inggunny/Laboratorio_de_robotica_movil_en_Cloud/piezas 3d/soporte motor individual.stl

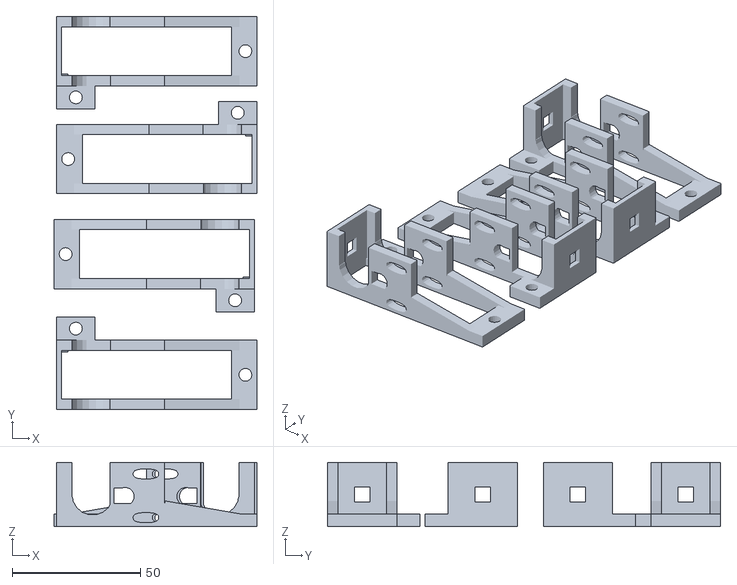
[picture p37: CAD file, 2019-08-13]
piezas 3d/soporte motor individual.stl
79.0 x 153.0 x 25.0
