inggunny/Laboratorio_de_robotica_movil_en_Cloud/piezas 3d/antena.stl

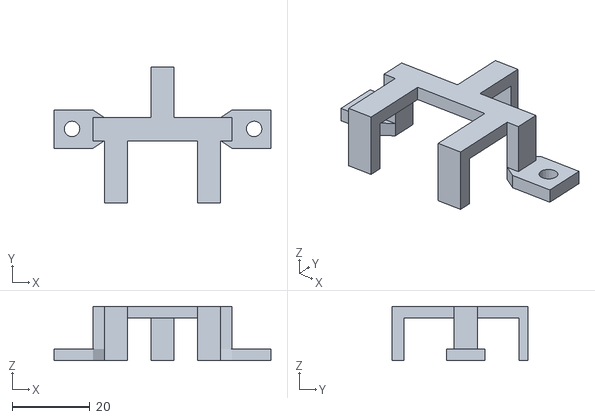
[picture p38: CAD file, 2019-08-13]
piezas 3d/antena.stl
56.0 x 35.0 x 14.0
