inggunny/Laboratorio_de_robotica_movil_en_Cloud/piezas 3d/ultrasonico.stl

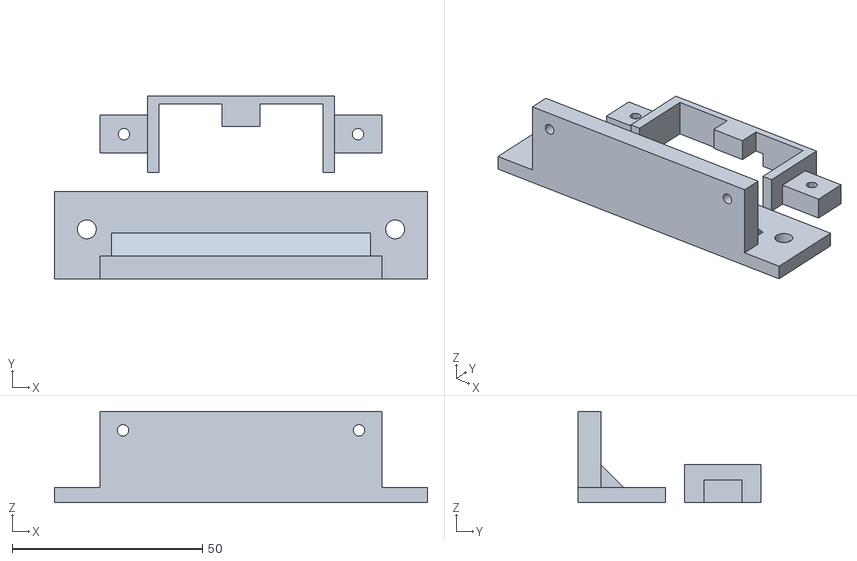
[picture p39: CAD file, 2019-08-13]
piezas 3d/ultrasonico.stl
98.0 x 48.0 x 24.0
