inggunny/Laboratorio_de_robotica_movil_en_Cloud/chasis acrilico.pdf

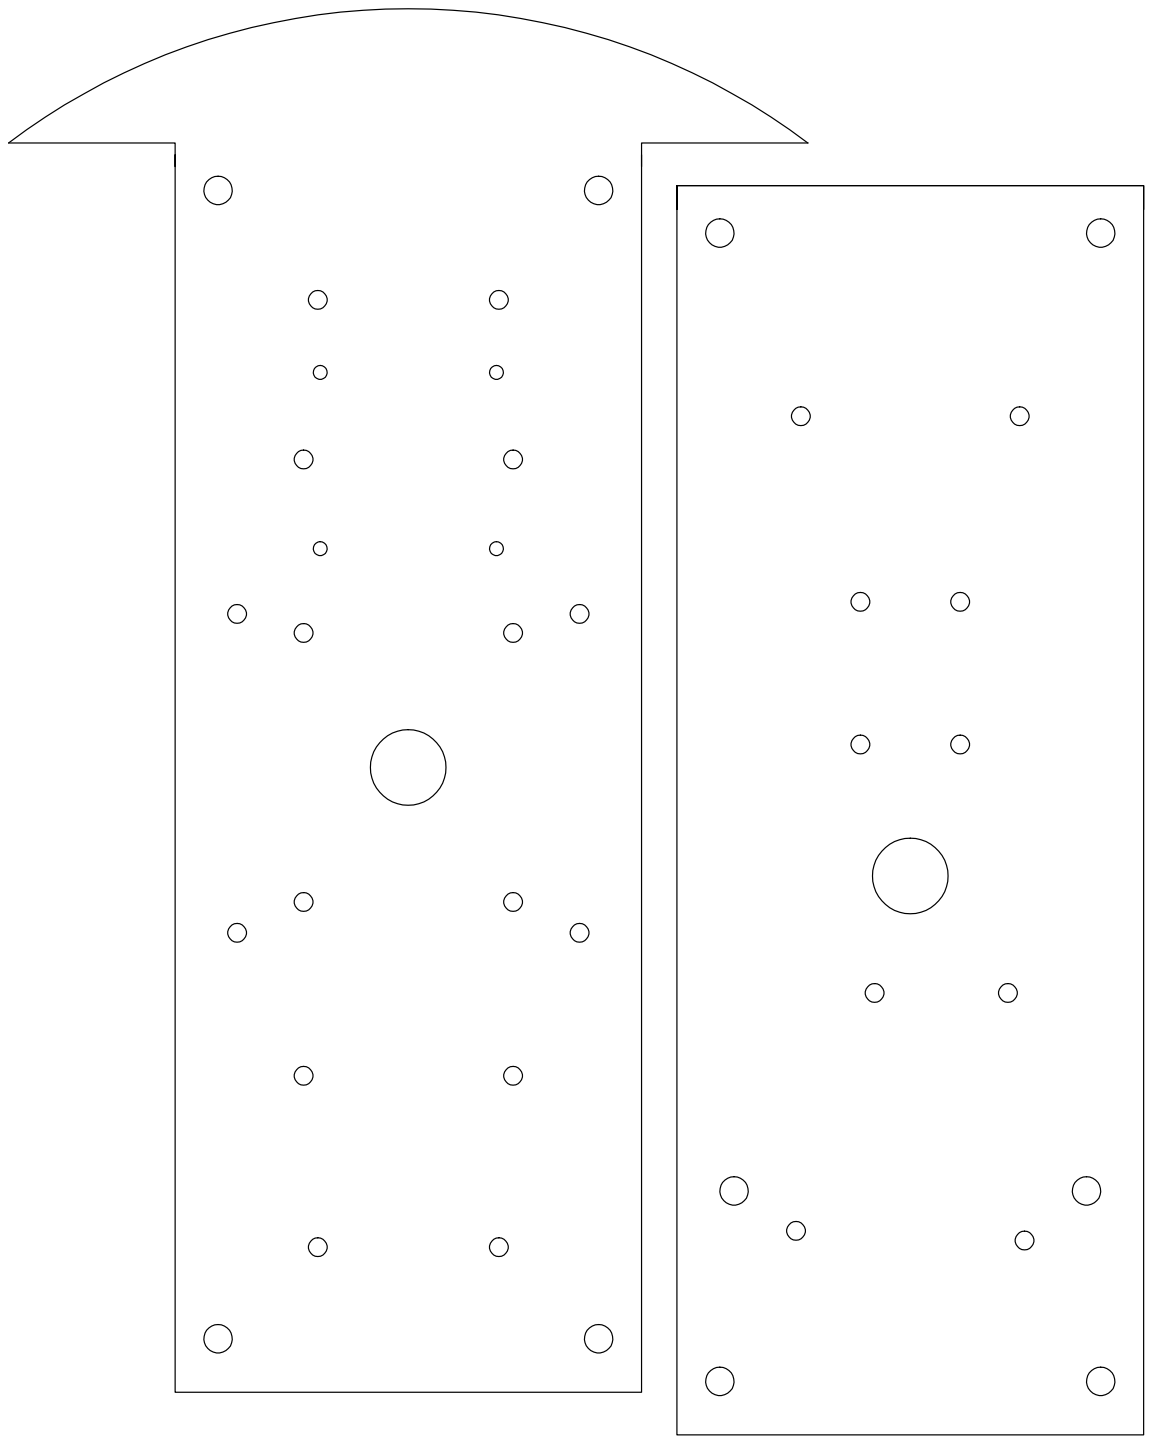
[picture p40: page 1]
