inggunny/Laboratorio_de_robotica_movil_en_Cloud/pcb/poten.PDF

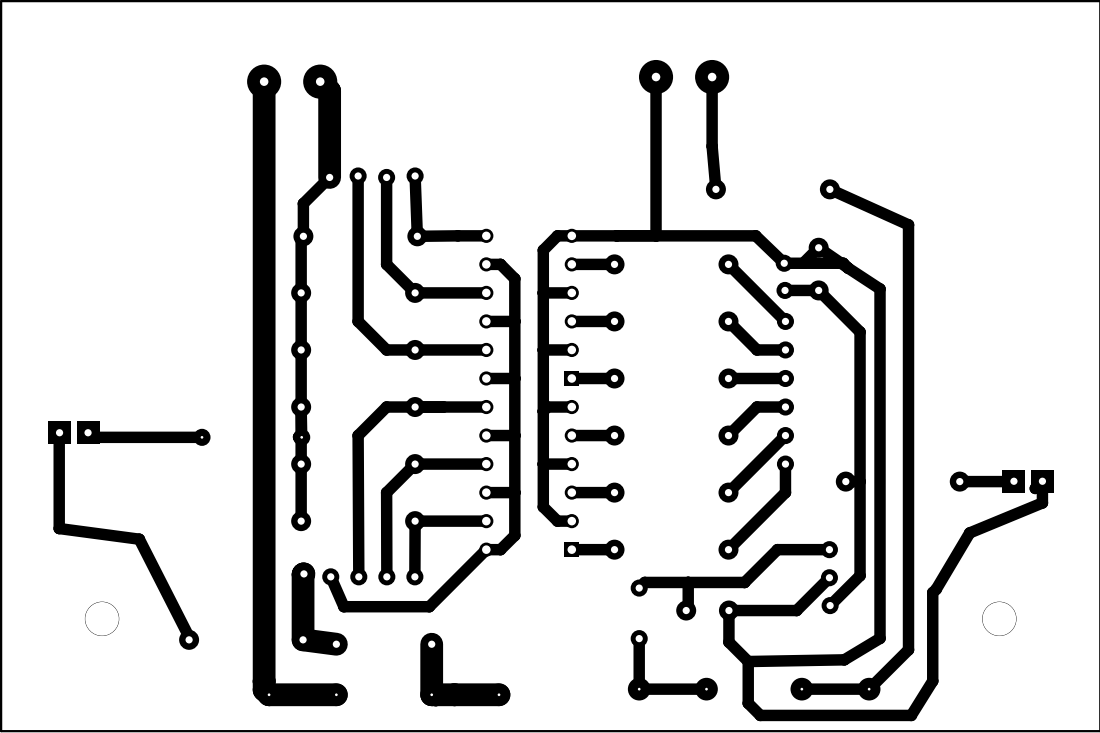
[picture p41: page 1]
