inggunny/Laboratorio_de_robotica_movil_en_Cloud/pcb/shieldtesis.PDF

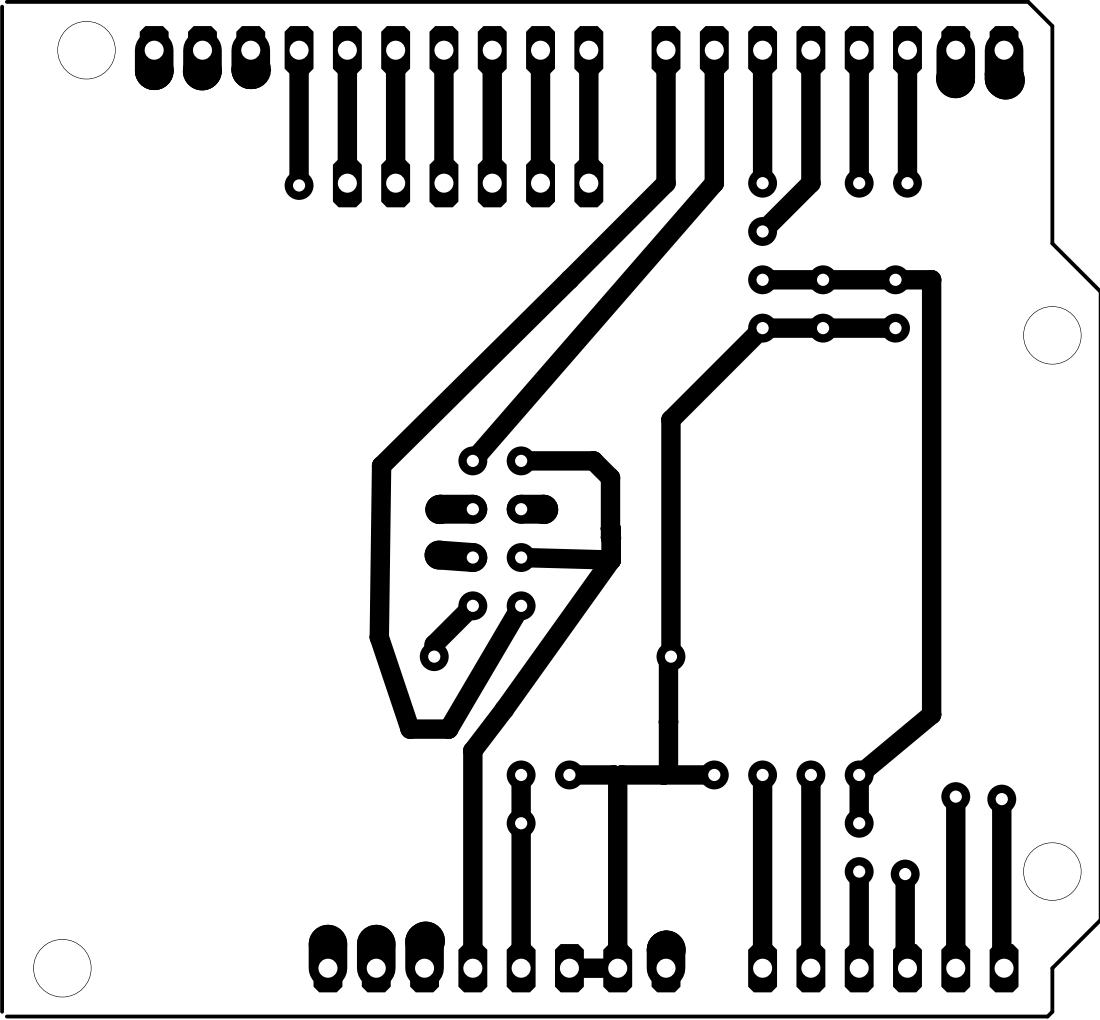
[picture p42: page 1]
