inggunny/Laboratorio_de_robotica_movil_en_Cloud/software/librerias/Ultrasonic/Ultrasonic.cpp

// Ultrasonic - Library for HR-SC04 Ultrasonic Ranging Module.
// GitHub: https://github.com/JRodrigoTech/Ultrasonic-HC-SR04
// #### LICENSE ####
// This code is licensed under Creative Commons Share alike 
// and Attribution by J.Rodrigo ( http://www.jrodrigo.net ).

#if ARDUINO >= 100
  #include "Arduino.h"
#else
  #include "WProgram.h"
#endif

#include "Ultrasonic.h"

Ultrasonic::Ultrasonic(int TP, int EP)
{
   pinMode(TP,OUTPUT);
   pinMode(EP,INPUT);
   Trig_pin=TP;
   Echo_pin=EP;
   Time_out=3000;  // 3000 µs = 50cm // 30000 µs = 5 m 
}

Ultrasonic::Ultrasonic(int TP, int EP, long TO)
{
   pinMode(TP,OUTPUT);
   pinMode(EP,INPUT);
   Trig_pin=TP;
   Echo_pin=EP;
   Time_out=TO;
}

long Ultrasonic::Timing()
{
  digitalWrite(Trig_pin, LOW);
  delayMicroseconds(2);
  digitalWrite(Trig_pin, HIGH);
  delayMicroseconds(10);
  digitalWrite(Trig_pin, LOW);
  duration = pulseIn(Echo_pin,HIGH,Time_out);
  if ( duration == 0 ) {
	duration = Time_out; }
  return duration;
}

long Ultrasonic::Ranging(int sys)
{
  Timing();
  if (sys) {
	distance_cm = duration /29 / 2 ;
	return distance_cm;
  } else {
	distance_inc = duration / 74 / 2;
	return distance_inc; }
}
