inggunny/Laboratorio_de_robotica_movil_en_Cloud/software/librerias/Ultrasonic/examples/PlugAndPlay/PlugAndPlay.ino

// Ultrasonic - Library for HR-SC04 Ultrasonic Ranging Module.
// Rev.4 (06/2012)
// J.Rodrigo ( www.jrodrigo.net )
// more info at http://www.ardublog.com
// Wiki: https://github.com/JRodrigoTech/Ultrasonic-HC-SR04/wiki/Plug-&-Play

#include <Ultrasonic.h>

Ultrasonic ultrasonic(5,6); // (Trig PIN,Echo PIN)

void setup() {
  Serial.begin(9600);
  pinMode(4, OUTPUT); // VCC pin
  pinMode(7, OUTPUT); // GND ping
  digitalWrite(4, HIGH); // VCC +5V mode  
  digitalWrite(7, LOW);  // GND mode
}

void loop()
{
  Serial.print(ultrasonic.Ranging(CM)); // CM or INC
  Serial.println(" cm" );
  delay(100);
}
